markmatthewanderson/voltmeter_shield/README.md

# voltmeter_shield
 Voltmeter shield to be used with Arduino Uno.
 ....swag
