markmatthewanderson/voltmeter_shield/fw/README.txt

Arduino code to operate the voltmeter.
Stretch Goal: Create an importable Arduino library.
