markmatthewanderson/voltmeter_shield/fw/psuedo code.rtf

#Software Pseudo Code

# Scaling

While loops to check the scale using the ADC

In the while loop a function call to 7 segment display
-variable decimal for smallest scale
-fault for over voltage

# 7-segment display

-shift register to control individual segments
-shift register or mix to control digit pin
