markmatthewanderson/voltmeter_shield/hw/pcb/voltmeter/voltmeter.csv

Reference | Quantity | Value | Footprint | Datasheet | Category | DK_Datasheet_Link | DK_Detail_Page | Description | Digi-Key_PN | Family | MPN | Manufacturer | Status
A0 | 1 | Arduino_UNO_R3_SHIELD | marks_footprint_library:Arduino_UNO_R3_SHIELD | https://www.arduino.cc/en/Main/arduinoBoardUno
C1 | 1 | 0.1u | Capacitor_SMD:C_0805_2012Metric_Pad1.15x1.40mm_HandSolder | ~
C2 C3 | 2 | 10u | Capacitor_SMD:C_0805_2012Metric_Pad1.15x1.40mm_HandSolder | ~
D1 D2 D3 D4 | 4 | LTST-C150TBKT | digikey-footprints:1206 | http://optoelectronics.liteon.com/upload/download/DS22-2000-026/LTST-C150TBKT(0630).pdf | Optoelectronics | http://optoelectronics.liteon.com/upload/download/DS22-2000-026/LTST-C150TBKT(0630).pdf | /product-detail/en/lite-on-inc/LTST-C150TBKT/160-1643-1-ND/573584 | LED BLUE CLEAR 1206 SMD | 160-1643-1-ND | LED Indication - Discrete | LTST-C150TBKT | Lite-On Inc. | Active
J0 | 1 | 1935161 | digikey-footprints:Terminal_Block_D1.3mm_P5mm | https://media.digikey.com/pdf/Data%20Sheets/Phoenix%20Contact%20PDFs/1935161.pdf | Connectors, Interconnects | https://media.digikey.com/pdf/Data%20Sheets/Phoenix%20Contact%20PDFs/1935161.pdf | /product-detail/en/phoenix-contact/1935161/277-1667-ND/568614 | TERM BLK 2POS SIDE ENTRY 5MM PCB | 277-1667-ND | Terminal Blocks - Wire to Board | 1935161 | Phoenix Contact | Active
LED0 | 1 | LDQ-M284RI | footprints4:LDQ-M284RI | https://www.digikey.com/product-detail/en/lumex-opto-components-inc/LDQ-M284RI/67-1427-ND/252632
Q1 Q2 | 2 | 2N7002 | digikey-footprints:SOT-23-3 | https://www.onsemi.com/pub/Collateral/NDS7002A-D.PDF | Discrete Semiconductor Products | https://www.onsemi.com/pub/Collateral/NDS7002A-D.PDF | /product-detail/en/on-semiconductor/2N7002/2N7002NCT-ND/244664 | MOSFET N-CH 60V 115MA SOT-23 | 2N7002NCT-ND | Transistors - FETs, MOSFETs - Single | 2N7002 | ON Semiconductor | Active
R0 | 1 | 10M | Resistor_SMD:R_0805_2012Metric_Pad1.15x1.40mm_HandSolder | ~
R1 | 1 | 3.74M | Resistor_SMD:R_0805_2012Metric_Pad1.15x1.40mm_HandSolder | https://www.digikey.com/product-detail/en/vishay-dale/CRCW08053M74FKEA/541-3-74MCCT-ND/1181191
R11 | 1 | 10K | Resistor_SMD:R_0805_2012Metric_Pad1.15x1.40mm_HandSolder | ~
R12 | 1 | 4.12K | Resistor_SMD:R_0805_2012Metric_Pad1.15x1.40mm_HandSolder | https://www.digikey.com/product-detail/en/panasonic-electronic-components/ERA-6AEB4121V/P4-12KDACT-ND/3075127
R13 R14 R15 R16 | 4 | 86.6 | Resistor_SMD:R_0805_2012Metric_Pad1.15x1.40mm_HandSolder | ~
R2 | 1 | 1.58M | Resistor_SMD:R_0805_2012Metric_Pad1.15x1.40mm_HandSolder | https://www.digikey.com/product-detail/en/panasonic-electronic-components/ERJ-6ENF1584V/P1-58BTCT-ND/4429143
R3 R4 R5 R6 R7 R8 R9 R10 | 8 | 300 | Resistor_SMD:R_0805_2012Metric_Pad1.15x1.40mm_HandSolder
U1 | 1 | SN74HC595DR | footprints2:SN74HC595DR | https://www.digikey.com/product-detail/en/texas-instruments/SN74HC595DR/296-14857-1-ND/562567
U2 | 1 | TL062CDR | footprints:TL062CDR | https://www.digikey.com/product-detail/en/texas-instruments/TL062CDR/296-1281-1-ND/276549
VR1 | 1 | MCP1541T-I_TT | digikey-footprints:SOT-23-3 | http://www.microchip.com/mymicrochip/filehandler.aspx?ddocname=en011331 | Integrated Circuits (ICs) | http://www.microchip.com/mymicrochip/filehandler.aspx?ddocname=en011331 | /product-detail/en/microchip-technology/MCP1541T-I-TT/MCP1541T-I-TTCT-ND/1979818 | IC VREF SERIES 4.096V SOT23-3 | MCP1541T-I/TTCT-ND | PMIC - Voltage Reference | MCP1541T-I/TT | Microchip Technology | Active
