markmatthewanderson/voltmeter_shield/hw/pcb/voltmeter/voltmeter.kicad_pcb

## KiCad design hw/pcb/voltmeter/voltmeter.kicad_pcb (2020-10-04)

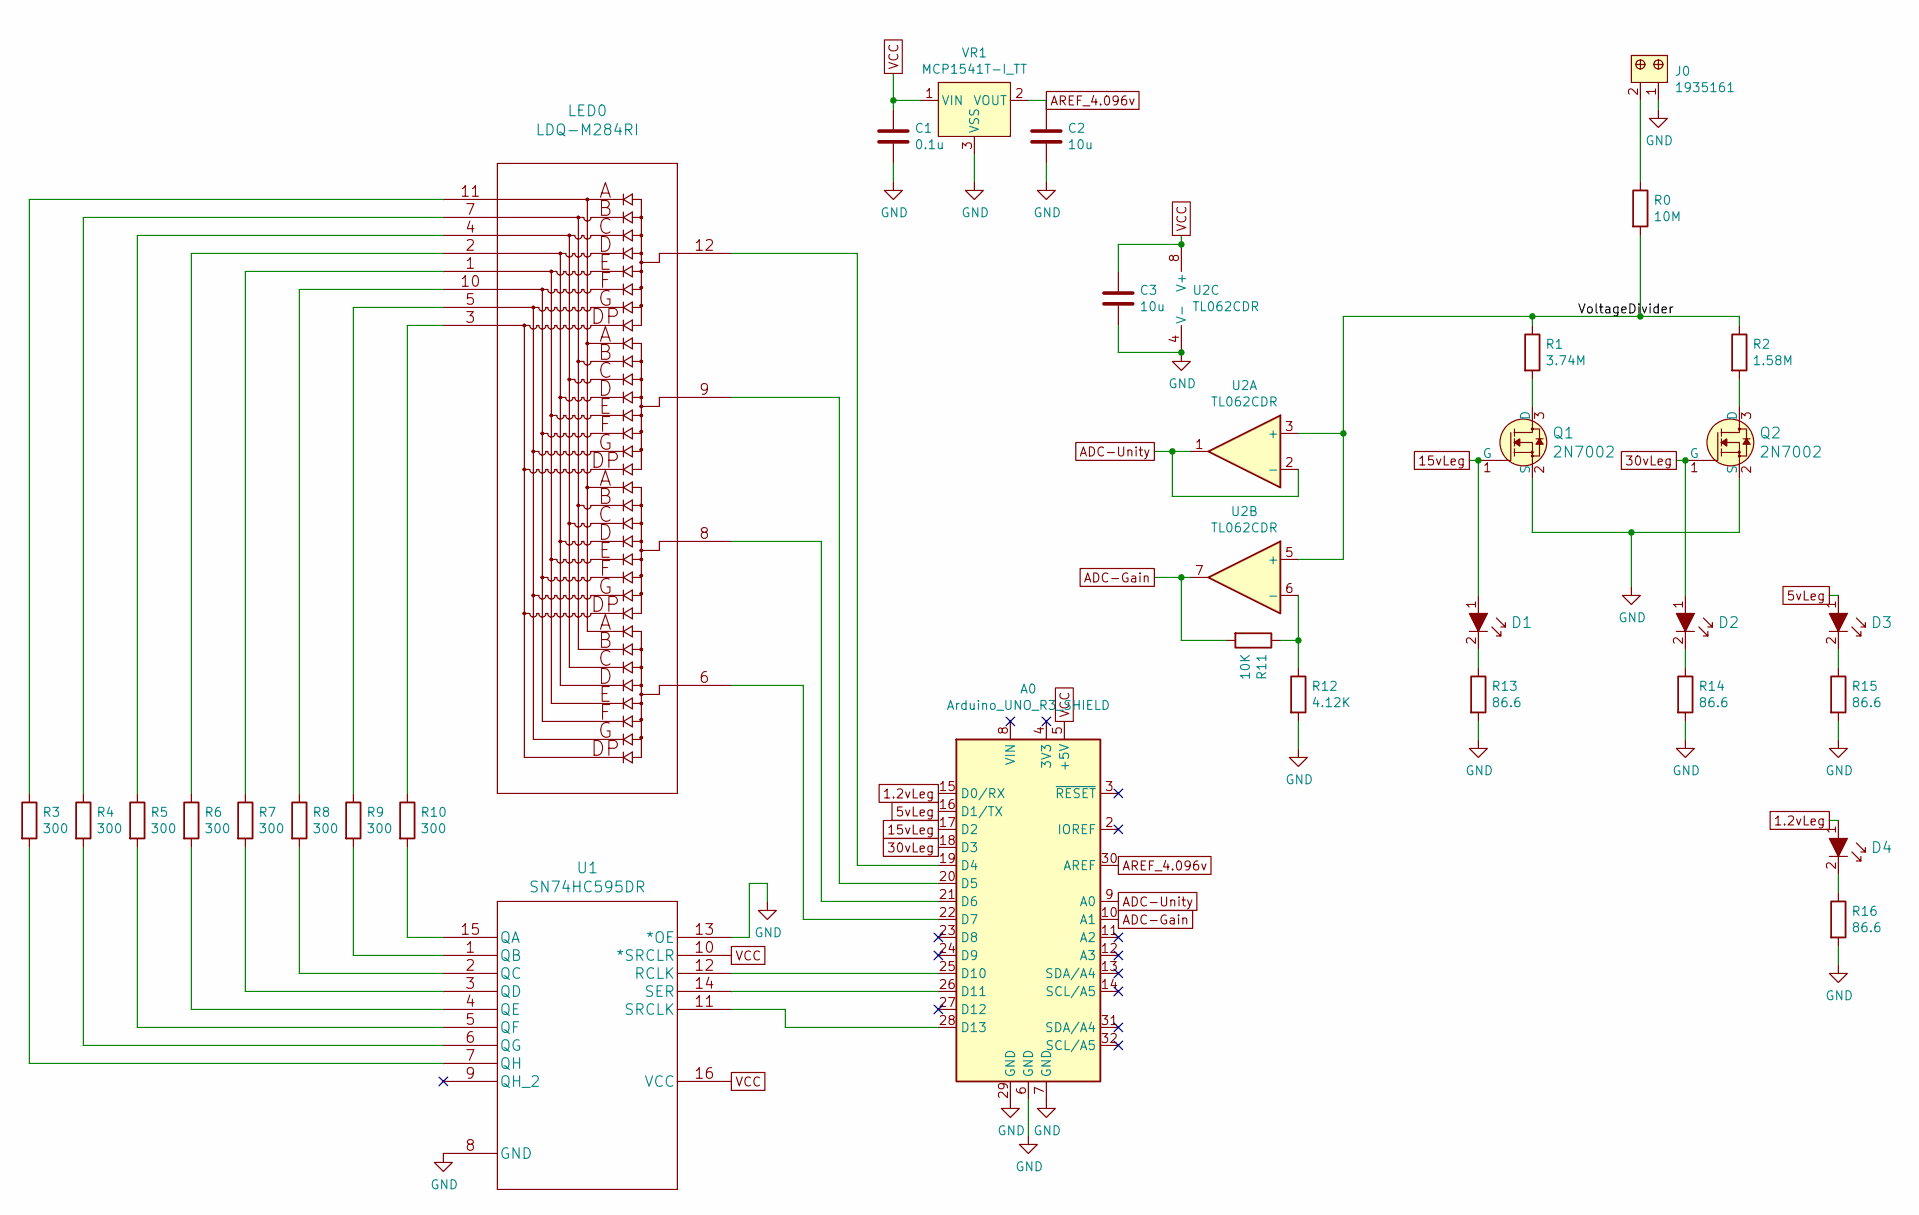
[picture p1: schematic voltmeter.sch]

Parts:
A0: Arduino_UNO_R3_SHIELD
C1: 0.1u; C_0805_2012Metric_Pad1.15x1.40mm_HandSolder
C2, C3: 10u; C_1210_3225Metric_Pad1.42x2.65mm_HandSolder
D1, D2, D3, D4: LTST-C150TBKT; 1206; MPN LTST-C150TBKT; Digi-Key_PN 160-1643-1-ND
J0: 1935161; Terminal_Block_D1.3mm_P5mm; MPN 1935161; Digi-Key_PN 277-1667-ND
LED0: LDQ-M284RI
Q1, Q2: 2N7002; SOT-23-3; MPN 2N7002; Digi-Key_PN 2N7002NCT-ND
R0: 10M; R_0805_2012Metric_Pad1.15x1.40mm_HandSolder
R1: 3.74M; R_0805_2012Metric_Pad1.15x1.40mm_HandSolder
R2: 1.58M; R_0805_2012Metric_Pad1.15x1.40mm_HandSolder
R3, R4, R5, R6, R7, R8, R9, R10: 300; R_0805_2012Metric_Pad1.15x1.40mm_HandSolder
R11: 10K; R_0805_2012Metric_Pad1.15x1.40mm_HandSolder
R12: 4.12K; R_0805_2012Metric_Pad1.15x1.40mm_HandSolder
R13, R14, R15, R16: 86.6; R_0805_2012Metric_Pad1.15x1.40mm_HandSolder
U1: SN74HC595DR
U2: TL062CDR
VR1: MCP1541T-I_TT; SOT-23-3; MPN MCP1541T-I/TT; Digi-Key_PN MCP1541T-I/TTCT-ND

Connections:
1.2vLeg: A0.15 (D0/RX), D4.1
5vLeg: A0.16 (D1/TX), D3.1
15vLeg: A0.17 (D2), D1.1, Q1.1 (G)
30vLeg: A0.18 (D3), D2.1, Q2.1 (G)
/VoltageDivider: R0.2, R1.1, R2.1, U2.3 (+), U2.5 (+)
ADC-Gain: A0.10 (A1), R11.2, U2.7
ADC-Unity: A0.9 (A0), U2.1, U2.2 (-)
AREF_4.096v: A0.30 (AREF), C2.1, VR1.2 (VOUT)
GND: A0.6 (GND), A0.7 (GND), A0.29 (GND), C1.2, C2.2, C3.2, J0.1, Q1.2 (S), Q2.2 (S), R12.2, R13.2, R14.2, R15.2, R16.2, U1.8 (GND), U1.13 (*OE), U2.4 (V-), VR1.3 (VSS)
unnamed: A0.19 (D4), LED0.12
unnamed: A0.20 (D5), LED0.9
unnamed: A0.21 (D6), LED0.8
unnamed: A0.22 (D7), LED0.6
unnamed: A0.25 (D10), U1.12 (RCLK)
unnamed: A0.26 (D11), U1.14 (SER)
unnamed: A0.28 (D13), U1.11 (SRCLK)
unnamed: D1.2, R13.1
unnamed: D2.2, R14.1
unnamed: D3.2, R15.1
unnamed: D4.2, R16.1
unnamed: J0.2, R0.1
unnamed: LED0.1, R7.1
unnamed: LED0.2, R6.1
unnamed: LED0.3, R10.1
unnamed: LED0.4, R5.1
unnamed: LED0.5, R9.1
unnamed: LED0.7, R4.1
unnamed: LED0.10, R8.1
unnamed: LED0.11, R3.1
unnamed: Q1.3 (D), R1.2
unnamed: Q2.3 (D), R2.2
unnamed: R3.2, U1.7 (QH)
unnamed: R4.2, U1.6 (QG)
unnamed: R5.2, U1.5 (QF)
unnamed: R6.2, U1.4 (QE)
unnamed: R7.2, U1.3 (QD)
unnamed: R8.2, U1.2 (QC)
unnamed: R9.2, U1.1 (QB)
unnamed: R10.2, U1.15 (QA)
unnamed: R11.1, R12.1, U2.6 (-)
VCC: A0.5 (+5V), C1.1, C3.1, U1.10 (*SRCLR), U1.16 (VCC), U2.8 (V+), VR1.1 (VIN)

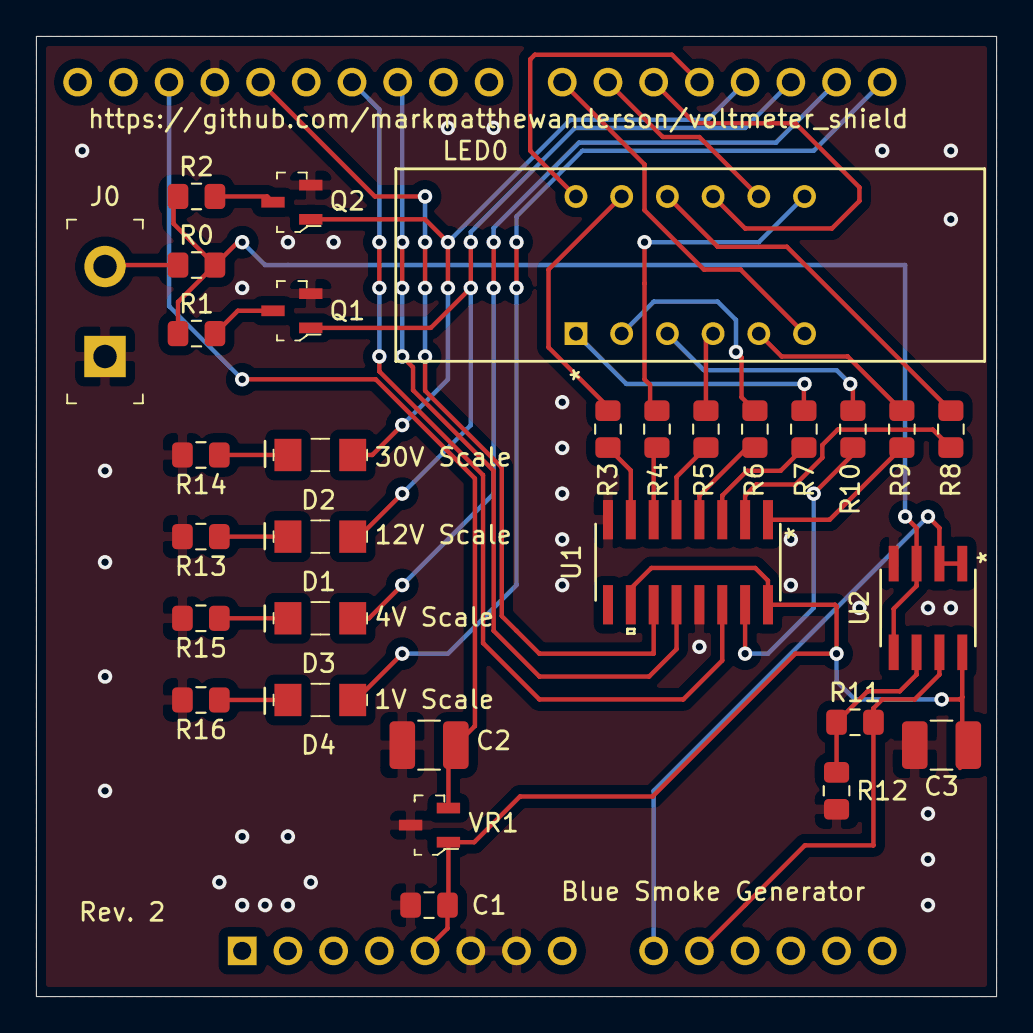
[picture p2: board voltmeter.kicad_pcb from above]

Board: 2 copper layers, 53.3 x 53.3 mm, 32 parts (0 on the bottom side), 41 nets.
