markmatthewanderson/voltmeter_shield/(commit log)

2020-08-21 Add blank Arduino and KiCAD projects.
    Created blank Arduino and KiCAD projects in their respective folders.
    [voltmeter.kicad_pcb, voltmeter.sch]
2020-08-21 Add ideas for voltage divider.
    Add resistor ideas for the voltage dividers for different voltage scales.
2020-08-22 Add ideas to arch, start schematic.
    Add ideas and details to architecture documents. Begin KiCAD circuit schematic and add to BOM.
    [voltmeter.sch]
2020-08-26 Updated circuit, added components, demo PCB layout. w/ Adam
    Picked some parts and added them to the circuit. Implemented ADC circuit suggested by Nick.
    [voltmeter.sch]
2020-08-26 Move to SMD parts; move to parts from Digikey library.
    Move to SMD parts; move to parts from Digikey library. Schematic updates.
    [bom.xlsx, voltmeter.sch]
2020-08-28 Changed to 4 voltage scales.
    Changed design from 3-scale to 4-scale. Selected a few more parts and added them to the schematic.
    [bom.xlsx, voltmeter.sch]
2020-08-31 Finished the schematic!
    Added 7-segment display, op-amps, and completed resistors and capacitors for ICs. First pass at the schematic is complete!
    [bom.xlsx, voltmeter.sch]
2020-09-01 Update voltmeter.ino
    Updated Psuedo Code
2020-09-01 Update voltmeter.ino
    psuedo code update
2020-09-02 Fix as many DRC errors as possible.
    Fixed DRC errors by marking unused pins and editing pin directionality on some schematic symbols.
    [voltmeter.sch]
2020-09-04 Begin PCB layout.
    Begin PCB layout. Edit Arduino footprint to better reflect the fact that it's just the header pins.
    [voltmeter.sch]
2020-09-17 Layout update.
    All components on the board. Saving a layout checkpoint for experimenting things.
    [voltmeter.kicad_pcb]
2020-09-17 Finished the layout!
    Committing finalized layout.
    [voltmeter.kicad_pcb]
2020-09-17 Generated gerber files.
    Generated gerber files. Beginning final component checks.
    [voltmeter-B_Cu.gbr, voltmeter-B_Mask.gbr, voltmeter-B_Paste.gbr, voltmeter-B_SilkS.gbr, voltmeter-Edge_Cuts.gbr, voltmeter-F_Cu.gbr, voltmeter-F_Mask.gbr, voltmeter-F_Paste.gbr]
2020-09-17 Fix incorrect 7-segment pinout.
    Fixed bad 7-segment pinout. Fixed layout; regenerated gerbers.
    [voltmeter-B_Cu.gbr, voltmeter-B_Mask.gbr, voltmeter-B_Paste.gbr, voltmeter-B_SilkS.gbr, voltmeter-Edge_Cuts.gbr, voltmeter-F_Cu.gbr, voltmeter-F_Mask.gbr, voltmeter-F_Paste.gbr]
2020-09-17 Added voltage scale labels to LEDs.
    Added voltage scale labels to LEDs. Regenerated gerber files.
    [voltmeter-B_Cu.gbr, voltmeter-B_Mask.gbr, voltmeter-B_Paste.gbr, voltmeter-B_SilkS.gbr, voltmeter-Edge_Cuts.gbr, voltmeter-F_Cu.gbr, voltmeter-F_Mask.gbr, voltmeter-F_Paste.gbr]
2020-09-18 Add pin mapping to Arduino code.
    Added pin mapping to Arduino code with #define statements.
2020-09-20 Finalize board for order.
    Finalized BOM, saved BOM from DigiKey.
    Updated layout to match updated BOM.
    [BOM.csv, bom.xlsx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]
2020-10-04 Schematic fix & updated Arduino pins.
    Fixed active low SRCLR pin on 595 shift register. Added test Arduino code. Fixed Arduino code pins.
    [voltmeter.kicad_pcb, voltmeter.sch]
2020-10-04 Update assembly_test.ino
    A little code clean up. Also experimented with enums (but commented it out).
2020-10-20 Added test Arduino code file for Mark.
    Added test .ino Arduino code file for Mark to play with. File name is mma_test.ino.
